rvodden/fluxtron/Component Models/WQP-PJ398SM.FCStd

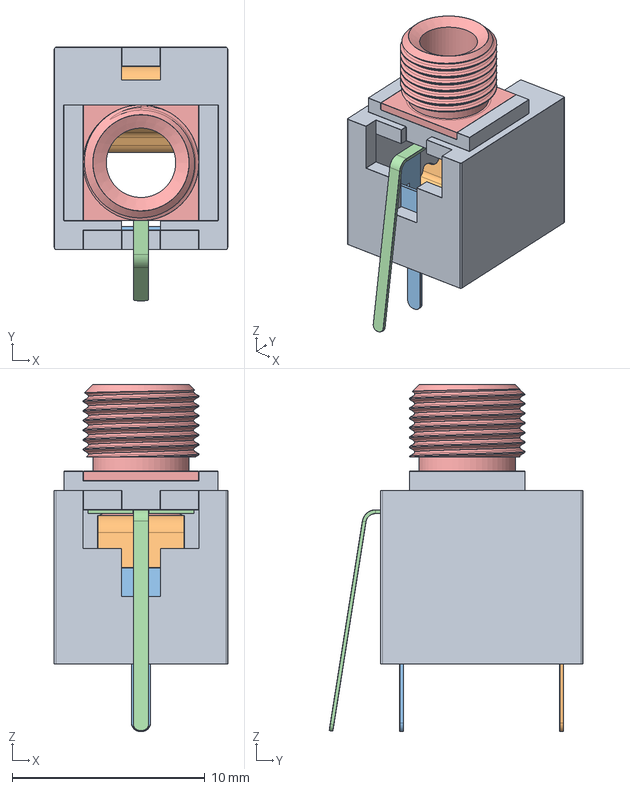
[picture p1: CAD file, 2026-09-19]
Component Models/WQP-PJ398SM.FCStd
9.00 x 13.2 x 18.0 mm
Pin 3
Pin 2
Pin 1
Socket
