rvodden/fluxtron/eurorack_panel.FCStd

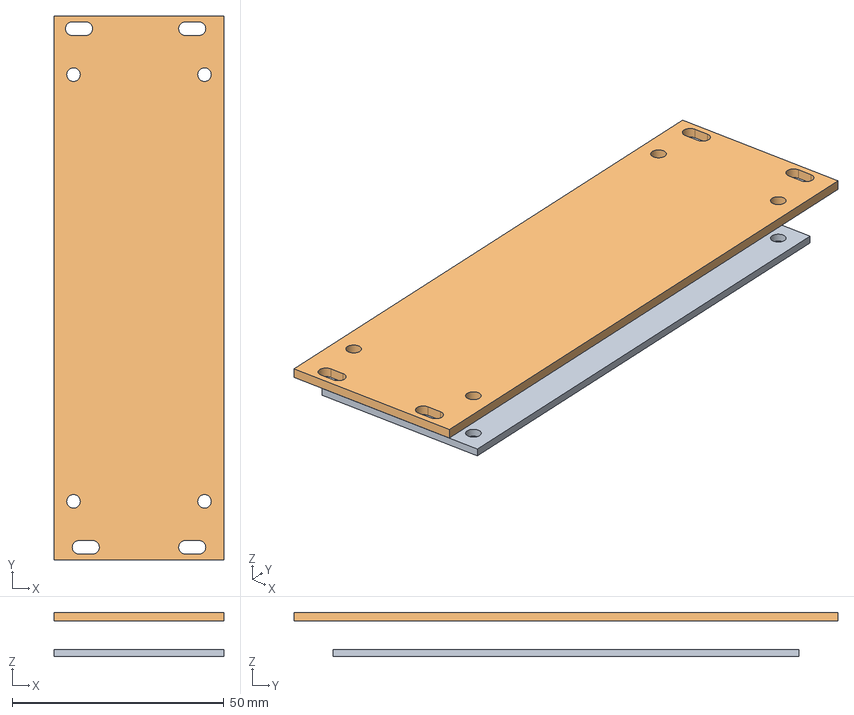
[picture p2: CAD file, 2026-09-19]
eurorack_panel.FCStd
40.1 x 128.5 x 10.4 mm
PCBBody
PanelBody
