rvodden/fluxtron/MC-1/MC_1.FCStd

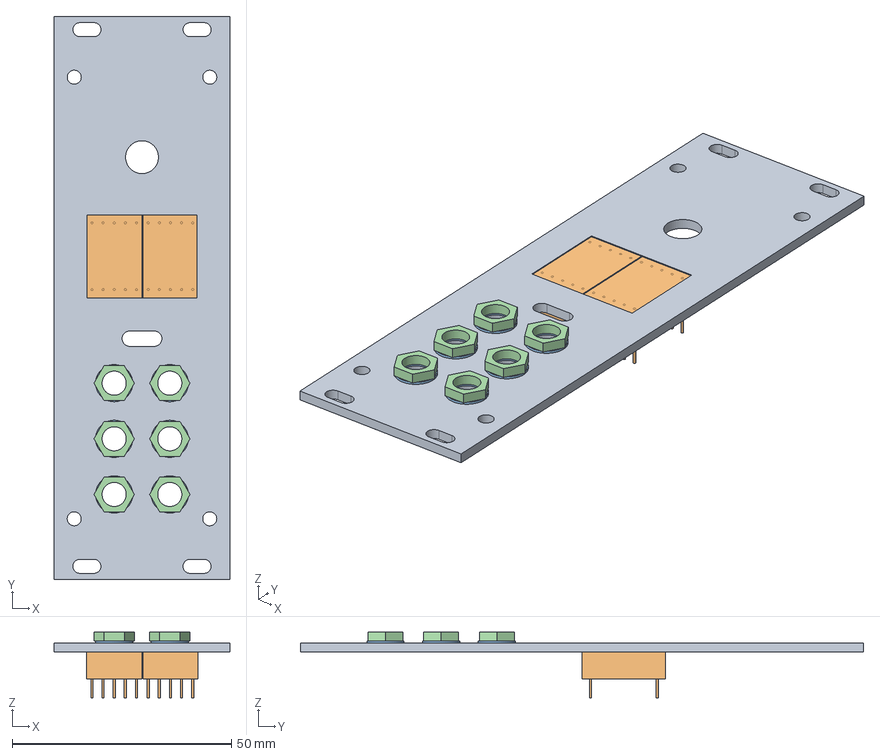
[picture p3: CAD file, 2026-09-19]
MC-1/MC_1.FCStd
40.2 x 128.5 x 15.0 mm
PanelBody
7SegmentDisplayBody x 2
NutBudy x 6
