rvodden/fluxtron/Component Models/PEC11R-4215F-N0024.FCStd

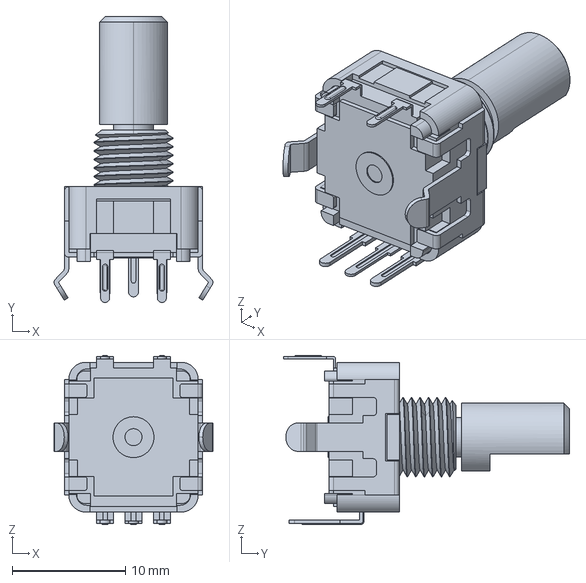
[picture p4: CAD file, 2026-09-19]
Component Models/PEC11R-4215F-N0024.FCStd
14.0 x 25.2 x 14.9 mm
