rvodden/fluxtron/Component Models/219320-0001.FCStd

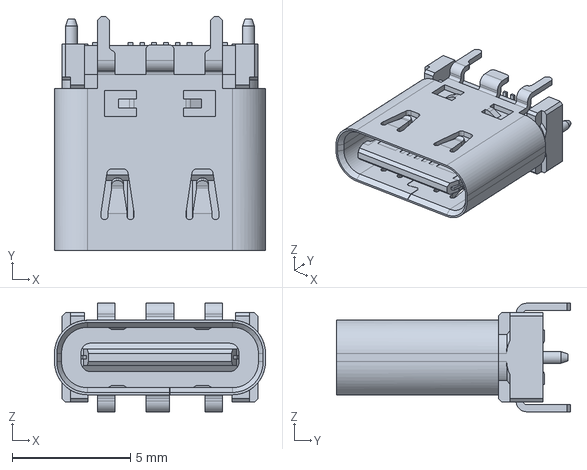
[picture p5: CAD file, 2026-09-19]
Component Models/219320-0001.FCStd
8.94 x 9.90 x 4.60 mm
