rvodden/fluxtron/(list of files, cad)

Other CAD files:
8HP_panel.FCStd
