rvodden/fluxtron/(commit log)

2026-09-13 Spec VO-1 VCO; adopt I2C bus in phase 1
    Add VO-1/CLAUDE.md covering the VCO: AS3340 core, closed-loop auto-tune
    via MCU frequency counting, 74HC74 sub-oscillator, LM13700 modulation
    depth control, and the 8HP panel layout.
    Spec'ing VO-1 surfaced three problems that are range-wide rather than
    module-specific, so the root and MC-1 docs are updated alongside:
    - No path existed for a MIDI CC to reach any module but MC-1. Resolved by
    using the 4-pin I2C bus from phase 1 with MC-1 as master, rather than a
    TRS MIDI IN on every module. Consequences recorded: every module now
    needs an MCU and a 3.3V rail, and the inter-module bus must not share an
    MCU I2C port with local peripherals.
    - Four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
2026-09-13 VO-1: adopt interleaved 8-jack panel layout
    Panel mockup fits all eight jacks by interleaving SYNC and PULSE into the
    space beside the large knobs rather than keeping jacks in separate rows.
    Triangle is kept; the earlier seven-jack compromise is dropped.
    Also:
    - Encoder sub-board no longer applies to VO-1 — the four encoders are
    scattered diagonally and interleaved with jacks, so a sub-board would
    span the whole panel. Flying leads (20 wires) instead.
    - Flag that the PEC16 "16.1mm behind panel" figure is unverified and
    probably an overall length including the M9 bushing. If so there is no
    clash with the 10mm main PCB and no cutouts are needed on any module;
    if not, every PEC16 n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
2026-09-13 VO-1: clustered-encoder panel layout; sub-board back on
    Second mockup keeps all eight jacks but clusters the four encoders into a
    2x2 block at the top, which restores the encoder sub-board the previous
    scattered layout had ruled out. Reverts the flying-leads decision and the
    matching range-wide note.
    - Module code corrected to VO-1; pitch input relabelled 1V/O.
    - Main PCB now stops below the encoder zone rather than spanning the full
    panel height: no notch required, but the analogue, digital and power
    sections plus eight jacks are squeezed into roughly 40x80mm. Expect
    4-layer.
    - Flag that the status LED has been dropped from the mockup. Auto-tune
    needs it; the gap between SYNC and P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
2026-09-13 VO-1: record mockup drawing conventions
    Oversize knobs represent finger clearance and the indicator lines mark a
    circle as a knob; neither is panel art. Replaces a note that wrongly read
    them as a spec requirement. Keeps the real decision it was reaching for:
    fitted caps carry no indicator, since incremental encoders have no
    absolute position to show.
    Claude-Session: https://claude.ai/code/session_01HjMuEyLG8Xm7HNeLA8xVKT
2026-09-14 Added CAD model for EuroRack Panel
    [MC_1.FCStd, eurorack_panel.FCStd]
2026-09-14 MC-1: resolve panel layout; spec switchable clock division
    Panel: the row-of-4 jack problem is resolved. Six jacks now sit two
    across over three rows with USB-C on its own row, which is the
    "comfortable" case of the range-wide jack-density rule rather than its
    three-across maximum. MC-1 closes at 8HP and the 16HP fallback is off
    the table. Replaced the stale "may not close at 8HP" warning with the
    constraint that actually binds now: vertical height, with only a few
    millimetres of slack on estimated footprints.
    CLK output: division is switchable rather than fixed, via a second
    2-digit display (DIV) beside the existing channel display. 15 values
    covering straight, triplet and dotted families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
2026-09-14 Settle V/OCT as the range-wide pitch jack label; VO-1 status LED sited
    VO-1's pitch input moves from 1V/O to V/OCT, matching MC-1's pitch
    output so both ends of a patch cable read the same. Recorded in the root
    doc as a range-wide convention rather than left as two modules that
    happen to agree, and the corresponding MC-1 open item is closed.
    Prose references to the 1V/octave standard are left as they are — those
    describe the standard, not the panel legend.
    VO-1's status LED is no longer missing: it now sits in the row-6 gap
    between SYNC and PULSE, as the spec proposed. Rewrote that section from
    a gap report into a placement record.
    Opened one item in its place: the LED is drawn blue whi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
2026-09-14 Blue indicators range-wide: FluxTron is cold, not warm
    Settles indicator colour as a range-wide palette decision rather than a
    per-module one: every indicator LED, and every 7-segment where a blue
    part can be sourced, is blue. Withdraws the "warm glow" amber/orange
    suggestion that had been floated for MC-1's displays.
    Blue is not a drop-in substitution for red, and the two electrical
    consequences are recorded alongside the decision rather than left to be
    found at bring-up:
    - A blue LED drops 2.7-3.4V against red/amber's 1.8-2.2V, so it cannot
    be driven from a 3.3V MCU GPIO — allowing for the GPIO's own drop
    there is no headroom left across the series resistor at all. Indicator
    LEDs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
2026-09-14 MC-1: adopt GS2020CB-G blue display, superseding the OPS-D2010
    The display is now a blue GS2020CB-G x2, replacing the Opto Plus
    OPS-D2010 which was only in the spec for its 3mm thickness and whose
    blue availability was never confirmed.
    No public datasheet for this part number could be found from this
    environment, so the entry records the choice without inventing its
    figures. Four of them are load-bearing and are flagged as unknown rather
    than guessed:
    - Thickness, which is the sole reason the display daughterboard exists
    as a separate board at its own standoff.
    - Drive polarity, which decides whether the standing AS1115 polarity
    question closes. The part number hints at common cathode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
2026-09-14 MC-1: confirm GS2022CB-G against datasheet; 5V rail margin is tight
    Datasheet (Guangcai, rev A 2022.09.20) read and its figures recorded.
    All four previously-open questions close, and one of the answers is
    tighter than the earlier estimate:
    - 3.20mm thick, near enough the OPS-D2010's 3mm that the display
    daughterboard and its shallow standoff are unaffected.
    - Common cathode, which is the polarity the AS1115 wants, closing the
    question that was open against the common-anode OPS-D2010. Segment
    pinout recorded.
    - Blue InGaN Vf is typ 3.00V but max 3.80V. This confirms the 5V rail is
    mandatory rather than likely, and leaves only 1.2V for the AS1115's
    segment and digit drivers in seri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
2026-09-14 MC-1: black reference surface on the display; add datasheet to repo
    Switches the display from GS2022CB-G to GS2022CB-B. Black makes unlit
    segments disappear into the matte black panel, so the display reads as
    blue characters floating on the panel rather than as a grey rectangle
    stuck to it. No electrical difference between the variants, so this is
    purely the cold-palette call, and it closes the open item.
    Notes the part-number quirk while it is fresh: the B in CB-B means
    different things in its two positions, blue emitter and black surface.
    Also adds the Guangcai datasheet to a new top-level datasheets/ folder
    and links it from the display entry, so the figures in the spec can be
    checked a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
2026-09-14 Adopt Bourns PEC11R range-wide; the encoder depth question is closed
    Replaces the PEC16 with the 12 mm PEC11R across the range, and with it
    retires the flagged unknown that the range doc said "changes every
    module, MC-1 included": whether a PEC16 body extends 16.1 mm behind the
    panel and punches a ~14 mm clearance hole through every main PCB.
    It does not. The PEC11R sits 6.5 mm behind the mounting surface, in both
    the switched and unswitched variants, which is shallower than the 10 mm
    jack-driven main PCB rather than deeper. No clash, no cutout, no
    keep-out, on any module. VO-1's main board in particular stays whole
    rather than taking four holes through the section carrying the AS3340,
    MCU,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
2026-09-14 Encoders: detentless, 15 mm shaft (PEC11R-4015F-N0024 / -S0024)
    Changes the detent option from 2 (24 detents) to 0 (none) and the shaft
    from 30 mm to 15 mm. MC-1 takes the -S0024, VO-1 four -N0024.
    The 15 mm shaft resolves the caution raised against the 30 mm part: ~13
    mm proud of a 2 mm panel is a good match for a standard Eurorack knob
    bore, where ~28 mm was not.
    Detentless rewrites the firmware note rather than just amending it. The
    earlier warning was that 24 detents against 24 pulses gives one
    quadrature cycle per click, so counting edges would step 4x per click.
    With no detents there are no clicks to align to, and the rule restates
    as a sensitivity choice: 24 pulses per revolution is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
2026-09-14 VO-1: switch all four encoders; push functions cover the orphaned params
    VO-1's parameter table listed three parameters with no panel control at
    all -- PWM CV depth, sub division, and calibrate now -- reachable only
    over MIDI. That contradicted the range premise that every parameter has
    panel encoders for hands-on control. Four switched encoders cover all
    three with one gesture spare.
    The wiring already assumed this: the sub-board's 13-line count has
    always read 4x(A,B) + 4x(switch) + common. Only the part number said
    otherwise. All four become PEC11R-4015F-S0024, which also keeps VO-1 to
    a single encoder BOM line.
    Assignments, and the constraint that shapes them: VO-1 has no display,
    so u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
2026-09-14 MC-1: add a CLK indicator LED, and restore the pulse-wave icon
    A blue THT LED beside the CLK jack, flashing on each emitted clock
    pulse. It answers two things the panel otherwise cannot: whether MIDI
    clock is arriving at all, and what rate is actually being emitted --
    a check on the DIV setting without reading the display.
    Costs no vertical space, which matters given MC-1's budget: it sits in
    the centre gap on the existing VEL/CLK row rather than taking a row of
    its own. Offset toward CLK, since an LED equidistant between VEL and CLK
    reads as belonging to both.
    Adding it also restores the pulse-wave icon. The original row-of-four
    layout specified one "centered between the middle two" jacks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
2026-09-14 Drop symbolic icons range-wide; everything is named in words
    The MIDI DIN end-view icon and the pulse-wave icon were in the original
    brief and are now rejected. Recorded in the same form as the footer
    wordmark rejection so they are not re-proposed: no icons, everything
    named in words -- jack names, control labels, and a plain word heading a
    section where one is needed.
    Losing the pulse-wave icon costs nothing. The CLK indicator LED sits
    beside a jack already labelled CLK, and proximity says the rest.
    Losing the MIDI DIN icon reopens a real problem rather than just
    removing decoration. All six of MC-1's jacks are identical Thonkiconns,
    and the icon was the proposed way to mark IN/THRU as ca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
2026-09-14 Settle the range-wide MCU: STM32G0B1, and record where settings live
    Closes the largest open item in the range. STM32G0B1CBT6 on every
    module, with per-module substitution to a smaller G0 left as a late,
    deliberately low-stakes decision.
    RP2040 was the standing suggestion and loses once the constraint is
    relaxed to one vendor rather than one part -- which removes the thing
    forcing a USB-capable MCU onto all seven boards. The deciding factors,
    strongest first:
    - I2C slave is the one peripheral every module depends on, and ST's is
    much the better of the two. RP2040's DesignWare block has slave mode
    as its roughest edge, which would have been a risk to manage on every
    board rather than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
2026-09-14 Record the MCP4728 as the range-wide parameter DAC
    Fills the "12-bit, 3+ channels; exact part not yet chosen" slot that was
    open in VO-1 and unwritten in MC-1. VO-1 uses three of four channels
    (pulse width, FM depth, PWM CV depth); MC-1 uses one (velocity).
    Being I2C rather than SPI is the thing that shapes its use: it sits on
    each module's local I2C port alongside any AS1115, never on the
    inter-module bus, per the two-port rule. Its default address does not
    clash with the AS1115's. On MC-1 it belongs on the 3.3V side of the
    AS1115 level shifter -- the AS1115 needs 5V only because blue segments
    demand it, and there is no reason to drag the DAC up with it.
    Three constraints recorded with it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
2026-09-14 Pitch DAC: AD5662 with a REF5025 reference, on VO-1 and MC-1
    Closes the last significant unchosen part. An AD5683R with a 2ppm
    on-chip reference would have saved the second component but is hard to
    source, so a discrete DAC plus reference it is.
    Three ordering details recorded, each easy to get wrong:
    - Specify the 3ppm/degC REF5025 grade, not the 8ppm. Reference drift
    lands straight on tuning: 0.72 cent over a 20C warm-up against 1.92,
    and the latter is perceptible on a sustained note.
    - Pick the midscale power-on reset variant. VO-1's oscillator free-runs
    and sounds immediately at power-up, so a zero-scale tune offset would
    drop it to the bottom of its range until firmware initia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
2026-09-15 MC-1: division on the knob, channel behind the push
    Inverts the encoder's two parameters. Turning now sets clock division;
    pushing reaches MIDI channel, which times out back to division after a
    few seconds without rotation.
    Division is the parameter that actually gets used -- channel is set once
    when the rack is patched and then left alone, while division is a
    performance control changed whenever the synced LFO should move at a
    different rate. The frequent operation belongs on the bare turn.
    The inversion is also right on blast radius, which is what makes the
    timeout worth specifying rather than just a plain toggle. A stray knock
    on the knob is survivable if it lands on division and disast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
2026-09-15 Pitch DAC: AD5693R, replacing the AD5662 + REF5025 pairing
    The discrete pairing was chosen on sourcing grounds after the AD5683R
    proved hard to find. The AD5693R is the same nanoDAC+ silicon over I2C
    rather than SPI, it is available, and so the reason for two parts went
    away.
    What it buys:
    - Its 2.5V on-chip reference at 2ppm/degC beats a REF5025 at its 3ppm
    grade -- 0.48 cent of warm-up drift against 0.72 -- while deleting a
    part and its capacitors from two modules. It also removes a class of
    mistake: there is no wrong reference grade to order by accident.
    - It closes VO-1's rail risk. A discrete REF5025 would have had to make
    2.5V from VO-1's 3.3V rail, since VO-1 has no AS1115 a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
2026-09-15 Guard the per-module MCU substitution with verified part-level limits
    Main settled the MCU independently and better than this branch did, so
    the branch's own reasoning is dropped rather than merged -- VO-1 returns
    to main's text verbatim, and the duplicate range-wide MCU section this
    branch introduced is removed. Note that git auto-merged that duplicate
    without a conflict, leaving two MCU sections disagreeing about whether
    the package was fixed.
    What survives is the part-level verification, which constrains a decision
    main deliberately left open ("decide per module when that module's
    schematic is real"). Checked against ST's CMSIS device headers, since ST
    and distributor domains are unreach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
2026-09-15 Add PS-1: power supply and bus board as their own module
    The PSU becomes a module in its own right rather than a section of MC-1,
    which is already the most crowded board in the range and carries the
    precision pitch DAC -- the last thing wanting a switching converter and a
    hot regulator beside it.
    Scope goes to 72HP of 84HP, leaving 12HP spare.
    The decision changes premises elsewhere, which is most of its value:
    - MC-1's 5V rail. The range doc reasoned "+12V is guaranteed on the
    10-pin header; a +5V rail is not", so MC-1 made 5V locally with an LDO
    from +12V burning ~560mW -- the worst thermal spot in the range, on its
    most crowded board. Owning the PSU removes that premise: MC-1 tak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
2026-09-15 PS-1: external brick settled, 15V in, and 3.3V moves to the 5V rail
    Brick confirmed over internal mains. Records why 12V does not work as the
    input: there is no headroom to regulate +12V from a 12V brick, so that
    rail would be the brick's raw output, unregulated and sagging under load,
    with nothing left to post-regulate the inverted rail either -- which would
    undo the range's linear-LDO policy at its source.
    15V is the sweet spot. The constraint pulls both ways: enough headroom to
    post-regulate both rails linearly, not so much that the linear stages
    cook. 18V roughly doubles the positive rail's dissipation and 24V needs a
    buck stage first.
    Flags that dropout is tighter than 3V of nominal h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
2026-09-15 Move PS-1 design detail out of the range-wide doc
    The root doc holds decisions that apply across the range; PSU internals
    are not that. Rail generation rationale, regulator dissipation figures,
    pull-up sizing and the current budget move to PS-1/CLAUDE.md, leaving the
    root doc only the rules a module author has to obey: there are +/-12V and
    +5V rails, the 3.3V LDO is fed from +5V, DVCC is 5V, and the pull-ups are
    on the bus board rather than per-module.
    Also records DVCC as 5V explicitly, and flags that 5V DVCC against 3.3V
    MCUs needs checking before any module's bus connector is laid out.
    Claude-Session: https://claude.ai/code/session_0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
2026-09-15 Correct the bus pull-up sizing: 100kHz, not 100/400kHz
    An earlier note here claimed a 2.2k pair suited both 100kHz and 400kHz
    against a 150-250pF segment. It does not. At 5V DVCC the 3mA sink spec
    puts a floor of 1.53k on the pull-up, while rise time puts a ceiling of
    300ns/(0.8473*Cb) at 400kHz; those cross at about 230pF, so above that
    there is no valid passive value at all. At 250pF a 2.2k pair gives ~466ns
    against a 300ns limit.
    The bus therefore runs at 100kHz. This does not cost anything, because
    the ATTN line means MC-1 reads a module only when it signals -- there is
    no round-robin polling load to spend bandwidth on, and a parameter write
    at 100kHz is ~400us.
    Records that 3.3V DVCC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
2026-09-15 Specify the inter-module bus protocol in BUS.md
    Closes the largest open item in the range. The protocol was load-bearing
    in phase 1 from the moment MC-1 became the only module receiving MIDI,
    and had never been written down.
    Presets are designed in rather than deferred, because the commit
    semantics cannot be retrofitted without touching every module's firmware.
    Presets live in MC-1, not the modules -- a preset is a property of the
    rack. Recall is stage-then-commit: parameters are written into a shadow
    copy, then a single general-call broadcast makes the whole rack switch at
    once, sub-millisecond skew, instead of audibly sweeping through
    intermediate states. Staging auto-aborts after ~1s so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
2026-09-16 Bus: 5V DVCC is under review, and pin down the bootloader constraints
    Checking the G0B1's 5V tolerance turned up that ST's FT structure is a
    level shifter referenced to VDD, not a clamp, so tolerance does not hold
    with VDD absent. Our topology guarantees that condition: every module's
    3.3V rail derives from the 5V rail, so 5V is necessarily up first on every
    power cycle, and a module whose 5V PTC trips sits unpowered indefinitely
    with the bus live across its pins.
    Series resistors cannot fix it. Against a typical +/-5mA injection limit,
    220R passes ~19.5mA when unpowered, and the 860R needed to reach 5mA puts
    the bus low level at ~1.4V against a 1.5V VIL. Injection protection and
    working I2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
2026-09-16 Correct the 5V DVCC analysis: overstated, but not resolved
    The datasheet marks every G0B1 I2C pin FT, so 5V tolerance holds in
    normal operation. The previous revision of this file was wrong on the
    magnitude of the remaining risk and should not have called 5V unviable.
    The injection figure was wrong. It treated 5V as a stiff source at the
    module pin, but the only path from DVCC to SDA/SCL is the bus board's
    2.2k pull-up -- every other device is open-drain and can only pull low.
    Injection into an unpowered pin is therefore capped around 2.1mA, inside
    a typical +/-5mA limit, not the ~19.5mA claimed.
    What does survive is a voltage limit rather than a current one, and it
    sits in a different row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
2026-09-16 Bootloader I2C: either I2C1 or I2C2, so locals go on I2C3
    AN2606's STM32G0B1xx/0C1x table gives a choice of peripheral. An earlier
    revision of BUS.md said the bootloader was I2C1 on PB6/PB7 only and
    "fixed, not remappable" -- that came from a community report about the
    G030 and was over-generalised. The pin set within each peripheral is
    fixed; the peripheral is not.
    The useful consequence is an allocation rule. The G0B1 has three I2C
    ports and the range-wide two-port rule needs the inter-module bus
    separate from the AS1115, MCP4728 and AD5693R. I2C3 is the port that is
    not bootloader-capable, so spending it on local peripherals leaves both
    qualifying ports free for the bus, which can then t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
2026-09-16 Record the AN2606 bootloader pins and limitations
    Pins from the STM32G0B1xx/0C1x table: I2C1 on PC6/PC7, I2C2 on PB10/PB11
    -- neither of which is the PB6/PB7 an earlier revision relayed. Flags that
    PC6/PC7 need checking against LQFP-48 bonding, since port C is thin on G0
    48-pin packages, and that one peripheral should be picked range-wide
    rather than per module.
    Three documented limitations change the update flow:
    - The Go command disables the debug access port by writing a wrong
    DBG_SWEN value. So Go is not used at all; the application is started
    with nRESET, which is cleaner regardless and is now the second
    independent reason that line earns its pin.
    - Multi-sector erase is broken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
2026-09-16 Correct the I2C1 bootloader pins: PB6/PB7, not PC6/PC7
    Both bootloader-capable peripherals are on port B -- I2C1 on PB6/PB7 and
    I2C2 on PB10/PB11 -- and both are bonded out on LQFP-48, so the previous
    revision's warning about port C bonding does not apply and the choice
    between the two is free.
    Claude-Session: https://claude.ai/code/session_01Rr1DtSYaVf3HWt6P7af52A
2026-09-16 Record the bootloader address and close the empty-check caveat
    Address is 7-bit 0x5D (0b1011101x; 0xBA write, 0xBB read), clear of the
    0x20-0x2F slot range, and the same on both I2C1 and I2C2 -- so the
    one-module-at-a-time constraint holds whichever peripheral the bus takes.
    The bootloader runs target mode, 7-bit addressing, analog filter on, up to
    1MHz, so it is not itself a speed constraint.
    The final AN2606 caveat confirms recovery from the empty-check crash needs
    an option byte change or a POR. An nRESET pulse is not a POR, so the
    backplane reset line cannot recover it -- only removing power can. That is
    why recovery is a BOOT0 jumper rather than anything bus-driven.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
2026-09-16 Settle DVCC at 5V, and correct the unpowered-module analysis
    5V is chosen for noise margin -- VIL 1.5V against 0.99V, plus the lower
    bus impedance of keeping 2.2k rather than the 4.7k that 100kHz would also
    allow. Explicitly not chosen for lower current: that intuition runs
    backwards, since the rise-time ceiling is voltage-independent and at any
    given resistor I = V/R, so 3.3V would draw less.
    Corrects the claim that a power-up violation window exists on every power
    cycle. It does not. DVCC and each module's LDO input are the same rail
    rising together, and the output follows the input during the ramp, so
    VDD+4.0 stays above DVCC throughout. A violation needs VDD held near zero
    while the inp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
2026-09-16 Bus: sequence diagram for a parameter update across a bridge
    Drawing the path out exposed two gaps in section 4, both now closed.
    The bridge had no defined interface for the thing it exists to do. Adds
    FORWARD (tunnelled write), INVENTORY (what the downstream segment holds,
    so discovery is one read per chassis rather than 16 tunnelled probes) and
    FWD_STATUS to the system register map. FORWARD is the one write that is
    not [reg, hi, lo]: its payload carries the NRPN address byte verbatim, so
    a bridge further down applies the same test to the same four bytes and the
    recursion needs no depth field or routing table.
    Acknowledgement semantics were undefined. Bridges are store-and-forward
    and ACK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
2026-09-16 Bus: record where CX-1 physically sits
    The spec described CX-1 as "slot 5 on chassis 0, master of chassis 1"
    without ever saying which backplane it plugs into. It can only be one, and
    geographic addressing decides which: CX-1 takes its slot from the A0-A3
    pins of the bus board it is seated in, so it must sit in the upstream
    chassis. In the downstream chassis its upstream address could not be
    geographic and would need a jumper, which is what the scheme exists to
    avoid.
    So one CX-1 per link, an ordinary 8HP module in the upstream chassis,
    mastering the downstream bus remotely through a PCA9615 pair. The
    downstream bus board terminates the cable, which makes the differential
    receiver a PS-1 bu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
2026-09-16 Bus: state the shared-address property, and define reads across a bridge
    Makes explicit that chassis 1 slot 3 and chassis 0 slot 3 both listen on
    0x23, each computed from its own backplane, and that this is intended
    rather than a collision -- they sit on physically separate buses with
    separate masters. Chassis identity is held by the bridge, never by the
    module, which is what lets a module move between cases unchanged.
    Closes a gap the addressing question exposed: FORWARD was specified as a
    write and nothing said how a read crosses a bridge. A synchronous read
    through a store-and-forward bridge would need it to clock-stretch for the
    whole downstream transaction, which breaks the ~1ms ceilin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
2026-09-16 Bus: assign chassis numbers at discovery, dropping the last jumper
    Section 3 said CX-1's chassis number was "set once, where a jumper is
    entirely reasonable". It does not need one. CX-1 is a slave on its
    parent's bus and already holds a geographically-derived address there, so
    the parent can reach it before it knows its chassis number and simply
    write one. MC-1 is chassis 0 by definition, finds a CX module on its
    scan, assigns it 1, then reads its INVENTORY and assigns any CX found
    there chassis 2 by tunnelling through the bridge it just configured.
    Bounded by the 3-bit field at 8.
    This works where general I2C auto-addressing does not, because the
    chicken-and-egg problem is absent: auto-add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
2026-09-16 Bus: sequence diagrams for startup and preset restore
    The startup diagram shows addressing, per-segment discovery and top-down
    chassis assignment in one place, including that a bridge masters its own
    segment before it is numbered and NAKs FORWARD until it is not.
    Drawing preset restore exposed two requirements in the multi-chassis case,
    both now recorded as mandatory:
    - A bridge must forward general calls. A general call reaches only the
    segment it was issued on, so without this a downstream chassis stages a
    preset and never commits it, leaving the rack half-switched.
    - A bridge must flush its forward queue before re-emitting the commit.
    Writes are store-and-forward, so staged values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
2026-09-16 Bus: reconcile ACK semantics, which two sections disagreed on
    Section 4 says bridges are store-and-forward and ACK before delivery, so a
    downstream NAK cannot propagate synchronously. Section 7 says MC-1 verifies
    every staged write ACKed before committing a preset. Each is locally
    correct and together they are wrong: across a bridge the ACK came from the
    bridge, not the module, so a remote module could receive none of its staged
    values while MC-1 sees clean ACKs and commits anyway -- producing exactly
    the half-switched rack the abort rule exists to prevent.
    Pre-commit verification is now two-part: local ACKs, plus every bridge in
    the path drained and reporting no delivery errors. FWD_STATUS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
2026-09-16 Bus: CX-1 has two ports and lives in the chassis it brings onto the bus
    The "not plugged into both" framing was true only of backplanes and
    obscured the topology rather than describing it. CX-1 has two bus ports: a
    local port into its own chassis's backplane where it is master, and an
    uplink port cabled to the parent chassis where it is a slave. It is
    connected to both, through two ports, which is the point of having two.
    Fixing the language exposed that the arrangement was also wrong. The
    bridge had been seated in the parent chassis because its address there had
    to come from A0-A3, but a bridge arrives by cable rather than by backplane
    position, so it needs no slot at all: it takes a reser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
2026-09-16 Bus: dedicated master port and CX port on the bus board
    A buffered link needs a transceiver at both ends, so hardware exists at
    the parent end whichever chassis the bridge module is seated in. That
    settles the arrangement: since the hardware is unavoidable, build it into
    the backplane as a dedicated CX port rather than have the link occupy a
    backplane position that could hold a module. The reserved 0x30 is then
    the honest description of a port that genuinely is not a slot, rather than
    a special case carved out of the slot range.
    Adds a dedicated master port at the left-hand end of every bus board,
    physically distinct so a slave module cannot be plugged into it by
    mistake. MC-1 uses it in ch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
2026-09-16 Bus: state that DVCC is the I2C signalling level, and clear stale text
    DVCC was introduced as "the pull-up reference" and every calculation since
    has assumed SDA and SCL swing to it -- the sink-current floor, VIL, the FT
    tolerance question, the 400kHz ceiling. That identity was never actually
    written down, which made "DVCC is 5V" and "the bus signals at 5V" look
    like two decisions when they are one.
    Also records why they cannot usefully differ: a DVCC that did not
    reference the pull-ups would have no job, since modules are forbidden from
    tying it to their local rail and +5V is already on the 16-pin power header
    for anything wanting a supply. Its only other duty, backplane-presence
    detection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
2026-09-16 Bus: retract the PCA9615 level-translation concern
    The previous revision flagged the PCA9615 as a 3.3V-class part needing
    level translation against the 5V bus, and counted that as an uncounted cost
    of the 5V DVCC decision. That was asserted from memory and is wrong.
    The datasheet gives two supply pins: VDD(A) for the single-ended side and
    VDD(B) for the differential side. VDD(B) runs 3.0-5.5V, is 5.5V tolerant,
    and best operation is at 5V -- so the part prefers this bus's logic rail
    rather than merely tolerating it.
    The split supply also makes it an inherent level translator, so the CX port
    is independent of whatever DVCC is set to: at 3.3V DVCC, VDD(A) would sit
    at 3.3V while VDD(B) still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
2026-09-16 Bus: connector summary, and specify the master port
    Adds a four-row summary of the distinct connector formats up front. Every
    pin count differs -- 16 or 10 for power, 12 for the module bus, 8 for the
    master port, RJ45 for the uplink -- so no two can be cross-plugged, which
    is the same mechanical reasoning as the existing never-a-10-pin-bus rule.
    The master port had been recorded only as "physically distinct" without
    saying how. It is now a 2x4 header carrying the module bus signals minus
    A0-A3, which a master has no use for. The narrower shell is what stops a
    slave module being plugged into the master port and a master module into a
    numbered slot.
    Also repairs the module bus pinout table,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
2026-09-16 Consistency sweep across BUS.md and the module open-item lists
    A full read of BUS.md after many in-place rewrites. Thirteen fixes, the
    first of which is a genuine defect rather than stale prose:
    - DIRTY is a 32-bit bitmap at 0x87, so it spans 0x87-0x88, but COMMAND was
    also at 0x88. COMMAND moves to 0x89 and DIRTY's span is now explicit.
    - The preset diagram still showed the one-part "every staged write ACKed?"
    check that the prose two commits ago replaced with the two-part check
    including bridge drain and FWD_STATUS.
    Six left over from moving the bridge to a reserved 0x30 and into the child
    chassis: traffic described as going to "the bridge's slot address"; the
    slot-15 rejection jus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
2026-09-16 Restructure BUS.md as a layered bus specification
    Reorganised bottom-up the way a bus spec conventionally reads: scope and
    invariant, physical, electrical, addressing, link, logical, bridging,
    application. The previous order had grown by accretion -- connector
    mechanics sat with voltages, addressing preceded the transaction model it
    depends on, and multi-chassis was one blob spanning three layers.
    Bridging is now split by layer with cross-references rather than kept
    whole: physical seating in 2.4 and 2.6, addressing in 4.4 and 4.5,
    forwarding and chassis assignment in 7. That is what a real bus spec does,
    at the cost of a bridge no longer being readable in one sitting.
    Adds a message catal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
2026-09-16 Bus: specify Panic, with "safe" defined per module
    Panic stays in the protocol. The rack is too heterogeneous for a central
    definition of safe -- MC-1's is a safe CV and a dropped gate, a mixer's is
    levels at zero -- so this file defines the message and the obligation, and
    each module's own spec defines the state.
    Five things the protocol can fix because they are the same everywhere:
    - Immediate, never staged.
    - It aborts any staging in progress. Committing a half-staged preset
    because a panic interrupted it would be the opposite of safe.
    - It raises dirty flags, which inverts the commit rule. After a commit
    MC-1 knows every value because it wrote them; after a Panic it does not,
    bec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
2026-09-17 Confirm the 16-pin power header range-wide
    The docs held two statements that cannot both be true: that every module's
    3.3V LDO is fed from the bus +5V, and that modules not needing 5V keep a
    10-pin header. If every module derives 3.3V from +5V then every module
    needs +5V, so there is no module that can keep 10-pin. The carve-out was
    written before 3.3V moved onto the 5V rail and was never revisited.
    Deriving 3.3V from +12V instead would be 0.4W per module against 78mW,
    roughly 3.2W of scattered heat across a phase-1 rack against 0.6W, and on
    VO-1 that regulator sits beside the expo converter its own spec demands
    thermal separation from.
    The root cause was two different needs sharing one na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
2026-09-17 Spell out that 2x8 is mandatory module-side, and its consequences
    The 16-pin requirement is a module-side connector mandate, not just a bus
    board one: a 2x5 header physically omits the +5V pins, so a module cannot
    have one and still take the rail its 3.3V LDO runs from. Stated in the
    protection standard in connector vocabulary rather than as a pin count.
    Three consequences that were implied rather than written:
    - Board width. A 2x8 shrouded header is about 8mm wider than a 2x5, worth
    checking on VO-1 whose main board is already down to roughly 40 x 80mm.
    - The +5V PTC. The per-module overcurrent rule already says "each power
    rail", but +5V is now one of those on every module rather tha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
2026-09-17 Bus: how CV and Gate reach a second chassis
    The bus CV/Gate pair is per-segment and stops at the chassis boundary,
    which was never stated. A second MC-1 in the downstream chassis extends
    it, fed from the first's TRS MIDI THRU -- a capability MC-1 already has,
    so this costs no new design. Each MC-1 drives its own chassis's bus lines,
    referenced to that chassis's own ground, and nothing analogue crosses
    between cases.
    Rejects carrying CV over the inter-chassis link. A cent at 1V/oct is
    833uV, and two chassis have separate PSUs bonded only through the shields
    of whatever patch cables run between them -- uncontrolled and carrying
    return current. 10mV of ground offset is 12 cents, 50mV is 60, an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
2026-09-17 Bus: carry CV and Gate to a second chassis over a differential link
    Replaces the previous recommendation of a second MC-1 per chassis, which
    was wrong twice over.
    It is architecturally blocked: CX-1 masters the downstream segment, so an
    MC-1 there gives that segment two masters. Avoiding that means rolling
    CX-1's function into MC-1, which then needs two inter-chassis cables, MIDI
    and I2C, since note data cannot ride the bus. And it is far more
    expensive -- MC-1 carries a USB-C daughterboard, a display, an AS1115, an
    opto and three PCBs, against a differential receiver and a gate buffer.
    The two objections resolve each other: with a differential link the child
    chassis needs no MC-1 at all,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
2026-09-17 Bus: make the inter-chassis gate differential too
    Better than symmetry: with all four Cat5 pairs differential, no signal
    return current flows in the ground at all, so the reference only has to
    hold the two chassis within the receivers' common-mode range. The cable's
    shield is entirely adequate for that where it would not be for a return.
    Going fully differential therefore buys back the fourth pair rather than
    costing one, and needs shielded Cat5 and shielded RJ45 jacks.
    It also deletes a mitigation. A differential gate's fields cancel, so it
    does not couple into the adjacent I2C pairs and the edge needs no slew
    limiting -- which was only there to answer a crosstalk objection that
    single-end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
2026-09-17 Bus: one dual receiver carries CV and Gate, and no driver IC
    Checked for a dual analogue differential part as asked. Dual receivers
    exist -- INA2134, G=1, 90dB CMRR, on-chip precision resistors -- while
    DRV134 and DRV135 are both single-channel, differing only in package.
    The driver question turns out to be moot. Impedance-balanced sending needs
    no driver IC at all: drive the + leg and tie the - leg to the sender's
    ground through a matching series resistor, and the inter-chassis offset
    appears identically on both legs for the receiver to reject as common mode.
    That also removes the RS-485 gate link. A Eurorack bus gate is an analogue
    voltage, so the second INA2134 channel passes it through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
2026-09-17 Bus: INA2134 crosstalk checked, a non-issue by two orders of magnitude
    Channel separation is 118dB to 10kHz, so a 5V gate edge contributes
    5V/10^(118/20) = 6.3uV into the CV channel, or 0.008 cent against the
    833uV-per-cent budget. The previous note assumed -100dB and 0.06 cent; the
    real part is thirteen times better.
    Notes honestly that the specification stops at 10kHz while a gate edge is
    broadband, so the transient is not strictly covered -- then closes it out
    rather than leaving it hanging. The margin is enormous, the receiver's own
    14V/us slew limits the edge, and gate edges coincide with note changes,
    which are the moments a momentary pitch disturbance is least audible: the
    pitch is a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
2026-09-17 Add the inter-chassis receiver terms to the pitch error budget
    The error table assumed DAC, reference, scaling network and op-amp all in
    one box. A chassis taking CV from an upstream case over the CX link puts an
    INA2134 in the path, which adds two terms rather than one: offset drift,
    which is a fixed voltage, and gain drift from the on-chip resistor TCR
    tracking, which scales with signal.
    Both rows are marked cross-chassis only, since a locally generated CV does
    not have them, with the conversions given so the figures can be dropped in:
    offset as (uV/degC * 20)/833uV cents, gain as ppm/degC * 20 / 83 cents.
    Records a sensitivity table because the two terms are very differently
    weighted. O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
2026-09-17 PS-1: size the supply for 16 modules; 15V 3A brick, 16HP panel
    The bus hands out 16 slot addresses, so that is the number the rack can
    reach without a new addressing scheme. Sizing the supply for eight was
    sizing it for phase 1 rather than for the architecture.
    What the rescale changes:
    - +5V is the rail that breaks. 750mA no longer covers it; design for
    1.5A. +/-12V absorb the change on their existing ceilings, raised to
    700/600mA. Everything that scales badly scales badly on +5V, the rail
    that exists only because the 3.3V LDOs moved onto it.
    - Brick goes to 15V 3A. Bigger means more current at 15V, never more
    volts: 18V would nearly double the positive regulator's dissipation.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
2026-09-17 PS-1: 8HP after all, on a board perpendicular to the panel
    The previous commit declared 8HP dead on thermals. That was wrong, and
    wrong in a specific way worth recording: it applied the range-wide
    parallel-PCB rule to PS-1 without checking whether the rule's own
    justification reaches it.
    It does not. The rule exists because pots, encoders and jacks are built
    for a parallel board and would otherwise need right-angle variants. PS-1
    has none of the three — its panel is a DC inlet (chassis-mount on flying
    leads either way), possibly a switch, and THT indicator LEDs, which the
    LED rule already exempts from depth constraints.
    Turned perpendicular, an 8HP slot gives 68cm2 of board instead of 43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
2026-09-17 PS-1: feed the bus board over a cabled Micro-Fit 3.0, not a direct mate
    A direct board-to-board mate was floated in the previous commit as a
    free consequence of the perpendicular card sitting edge-on to the
    backplane. Rejected: it welds PS-1's board outline and mounting position
    to one backplane in one chassis. The range designs around a particular
    case without treating it as a constraint, and a cable also lets the bus
    board run off someone else's supply and PS-1 feed someone else's
    backplane.
    It costs nothing electrically, which is what makes the argument easy.
    300mm of 18AWG plus two crimp contacts is ~20mohm, so +5V drops 30mV
    against 1.7V of LDO headroom — noise next to the 0.7V a ser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
2026-09-17 Replace four estimated part figures with datasheet values
    TI and ams became reachable, so the specs this project had been
    carrying as estimates are now measured. Datasheets committed under
    datasheets/ so the next session does not re-derive them from memory.
    INA2134 (SBOS071) — the two figures the pitch error budget flagged as
    owed, and the answer is not the one the guess implied:
    Input offset drift +/-2 uV/C -> 0.05 cents
    Gain drift +/-1 ppm/C typ -> 0.24 cents
    +/-10 ppm/C MAX -> 2.41 cents
    The earlier note guessed "excellent TCR tracking" meant the 1ppm/C end.
    That was right about typical and silent about a 10:1 spread. At th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
2026-09-17 MC-1: the AS1115 5V margin closes, and the level shifter is mandatory
    Resolved against DS000206 (committed under datasheets/). These were the
    two tightest open electrical questions in the range.
    The 5V rail closes, with two conditions attached.
    The datasheet gives the driver drops as test conditions, not dropout
    figures: the segment driver drops 1.00V at 41mA, the digit driver 0.65V
    at 320mA. MC-1 runs 10mA/segment and so 80mA/digit, a factor of four
    below both, and the chain then needs 4.21V at V+ against a worst-case
    3.80V segment.
    Condition 1 — it works only because the display runs dim. At the
    datasheet's own test currents the same sum is 5.45V and does not fit
    under 5V at all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
2026-09-17 Reverse-polarity protection is a MOSFET, range-wide
    You are right that the drop is nearly nothing, and the docs were also
    overbuilding it: plain reverse polarity is not ORing or hot-swap, so no
    ideal-diode controller is needed. One FET and a gate resistor does it.
    The +5V rail is where this pays. A logic-level P-channel part at ~50mohm
    drops 6mV at a module's 126mA where a Schottky drops 300mV:
    logic-level P-FET 4.74V at the pin +0.54V
    Schottky 4.45V +0.24V
    silicon diode 4.05V -0.16V fails
    That more than doubles the AS1115 driver margin — the tightest electrical
    margin in the range — for the cost of a gate resistor. Recorded as the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
2026-09-17 PS-1: real Micro-Fit derating figures; the 8.5A quote was the wrong row
    molex.com partially opened up. Their CDN answers 503 to this environment
    and tools.molex.com stays unreachable, but the derating table surfaced
    via the search index, which is enough to correct the number and not
    enough to commit the PDF.
    The correction matters more than the conclusion does. The ~8.5A per
    contact this file previously quoted from memory is the 2-circuit
    wire-to-board best case, not a 2x4's:
    18AWG, 30C rise basis wire-to-wire wire-to-board
    2 circuits 7.0A 8.5A
    6 circuits 6.5A 7.0A
    12 circuits 6.5A 6.5A
    An 8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
2026-09-17 Close the 3.3V current spread and correct Micro-Fit against the real spec
    Rebased onto main to pick up the uploaded datasheets. Three of the four
    STM32 files are the same document, DS13560, which covers STM32G0B1CB
    despite none of the filenames saying "cb" — ST serves one family PDF
    under every part-number URL. Kept Rev 6 (Feb 2026), dropped the two
    Rev 5 duplicates, renamed both new files to the directory convention.
    The 18mA-vs-46mA spread is closed, and 46mA was the wrong one. Table 28
    puts the G0B1 at 8.6mA typ at 64MHz from flash with peripherals off, and
    the Table 36 adders bring a realistic slave to ~10.3mA:
    2 GPIO ports 0.40, I2C1 0.23, I2C3 0.06, 2 timers 0.63, DMA1 0.33 mA
    A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
2026-09-17 Pitch DAC: order the B grade — the "no wrong grade" claim was wrong
    The last two unverified parts are in. Both supply currents came in below
    the estimates, and the AD5693R datasheet contradicts a specific claim
    this project had been resting on.
    The range doc argued the on-chip reference "removes a whole class of
    mistake — there is no wrong reference grade to order by accident." It
    does not. The reference is graded:
    B grade (AD5693RB...) 2 ppm/C typ, 5 ppm/C max 0.48 / 1.20 cents
    A grade (AD5693RA...) 5 ppm/C typ, 20 ppm/C max 1.20 / 4.82 cents
    The grade is one letter buried mid-part-number — AD5693RBRMZ against
    AD5693RARMZ — which makes it more orderable-by-accident t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
2026-09-18 Pitch reference: correct the REF5025 comparison, which was not like-for-like
    Following a question about the typ-vs-max note in the previous commit, I
    fetched SBOS410 to settle it rather than leave it hanging. Two claims in
    the range doc do not survive.
    The comparison was typ against max. It read "0.48 cent against 0.72" for
    the AD5693R against a REF5025 at its 3ppm grade — but 0.48 is the
    AD5693R's typical and SBOS410 states the REF50xx grades as maxima
    explicitly. Like for like:
    REF50xxEI enhanced 2.5 ppm/C max 0.60 cents
    REF50xxI high 3 ppm/C max 0.72 cents
    AD5693R B grade 5 ppm/C max 1.20 cents
    So the discrete pairing is the better part on drift by ~0.5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
2026-09-18 upload led datasheet
2026-09-18 MC-1: settle the USB-C connector, consolidate the upper boards
    Works through the three drawings uploaded this session and records what
    they settle, plus two errors they expose.
    USB-C is settled as Molex 2193200001 (16-pin, USB 2.0, vertical, 8.80mm).
    Adds the derived panel cutout — a 9.3 x 3.5mm full-radius slot, clearing
    the 8.94 x 3.16 body rather than the 8.34mm mating oval, since Molex
    publish no cutout for a board-mount part. D+/D- are not internally bridged,
    so A6<->B6 and A7<->B7 are tied on the board.
    2171780001 is rejected and recorded so it is not re-proposed on its 2.3mm
    depth saving: its six contacts are CC1/CC2/VBUS x2/GND x2 with no data
    pins at all, so it cannot carry USB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
2026-09-18 MC-1: move the CLK LED out of the jack field, and measure the panel budget
    Panel mockup review. Two decisions and one measurement.
    The CLK indicator LED moves from the centre gap on the VEL/CLK row to the
    lower right of the encoder. The old position sat at jack height between the
    two columns, which is where patch cables are: a plug body stands ~10mm
    proud of the panel, so the indicator was obscured from any off-axis angle
    exactly when the clock mattered. The new position is in the control zone,
    and it lands on the UI daughterboard with the encoder, display and USB-C.
    It stays unlabelled, but the old reason no longer applies — it is now ~55mm
    from the CLK jack, so proximity to a labelled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
2026-09-18 One MC-1 per segment: a second MC-1 is a second system
    Two MC-1s in one chassis, daisy-chained by TRS THRU on different MIDI
    channels, would contend for the bus CV line, the bus Gate line and the
    master role. Only the master role announces itself; two drivers on the
    analogue CV line settle at an average, giving a plausible wrong pitch
    with no error raised anywhere and nothing calibration can reach.
    Record the rejection in BUS.md as a new §2.8, alongside §2.7's existing
    rejection of an MC-1 in a bridged chassis, with the alternatives that
    were weighed and declined — a per-module "drives bus CV/Gate" jumper
    (a setting that must differ between identical modules, the failure mode
    geographic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
2026-09-18 Reject a MIDI channel on CX-1; flag MC-2 as where polyphony goes
    Giving CX-1 its own channel, so one USB-C connection drives two voices,
    answers a question that is not open: the TRS THRU chain already does
    that, and §8 already makes the MIDI channel the system selector.
    Of the three things it might have bought, two evaporate — unified
    presets and panic are per-channel, so a host sends two of each, and
    unified NRPN addressing already works as (channel, chassis, slot). Only
    voice allocation is real, and that is the one thing it still could not
    deliver: allocation must happen where the notes arrive, so MC-1 would be
    shipping per-voice note assignments down the link.
    The blocker is §1 rath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
2026-09-18 Pitch budget: settle RSS vs linear, and separate the static floor
    The error table listed its terms but never said how they combine, and
    flagged that gap as deciding more than any part choice. Settled:
    - RSS is the design figure, linear is the guarantee figure, and neither
    is quoted without saying which. Records why RSS is defensible here —
    the drift terms are coefficients against one shared dT, and it is the
    coefficients that randomise — and that RSS of datasheet maxima is a
    convention with no confidence level, not a probability statement.
    - The reference at its 5ppm/degC max is 86% of the variance. The other
    five terms move the RSS total by 0.10 cent between them, which retir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
2026-09-19 Bus takes I2C1 on PB6/PB7, range-wide
    The last genuinely undecided item in BUS.md section 9 that was blocking
    schematic work: every module's pin map depends on it, and five module
    specs are still unwritten.
    Both candidates are bootloader-capable per AN2606, both on port B, both
    bonded out on LQFP-48 — the choice was free. Made arbitrarily rather
    than argued, and recorded as such so nobody goes looking for a technical
    reason later. What matters is only that every module agrees, the bus
    being one shared net.
    I2C2 is noted as staying free on every module: a spare local peripheral
    port, and the fallback if PB6/PB7 ever proves awkward on some layout —
    but taking it is a range-wide re-decisi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
2026-09-19 Define COMMAND opcodes, CAPABILITIES/STATUS, and the NRPN command set
    Three of BUS.md section 9's four owed definitions, written together
    because they are one design: opcodes without a capability bit leave MC-1
    guessing which modules can run them, and a write-only COMMAND with no
    rejection path in STATUS makes a refused command invisible.
    New section 6.8:
    - Encoding. [0x89, op, arg] — hi is the opcode, lo its argument. Opcode
    0x00 is NOP and must never be anything else: a truncated transaction
    or a stuck bus delivers zeros, and zero must not calibrate a module.
    - The rule that matters most: a command's ACK means *accepted*, never
    *done*. Clock stretching is bounded at ~1ms and auto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
2026-09-19 Upload local work
    [219320-0001.FCStd, 8HP_panel.FCStd, MC_1.FCStd, PEC11R-4215F-N0024.FCStd, WQP-PJ398SM.FCStd, eurorack_panel.FCStd]
2026-09-19 MC-1 display settled: SLR0522DBC3BD, and it retires the jack-pitch gate
    The uploaded datasheet (C2913048.pdf, Dongguan Sunlight) is the
    common-cathode sibling of the rejected SLR0562DBA3BD. Polarity confirmed
    twice: the text states the common-cathode marking, and the wiring diagram
    agrees — the diodes point into the DIG.1/DIG.2 rails, so the commons are
    the cathodes, which is what the AS1115 needs.
    It is also 0.52" rather than 0.56", which turns out to matter more than
    the polarity fix:
    - Body is 25 x 17.5 x 7.0mm against the rejected part's 25 x 19 x 8.0mm,
    so the vertical budget gets 1.5mm back.
    - Three jack rows at the range-validated 13.5mm pitch cost 1.1mm more
    than at 12.95mm.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
2026-09-19 added nuts and bolts
    [219320-0001.FCStd, MC_1.FCStd, PEC11R-4215F-N0024.FCStd, WQP-PJ398SM.FCStd]
